jedp/STM32F030-breakout/README.md

# STM32F030 Breakout board

- 16MHz HSE
- 32k LSE
- USB C connector (power only - no USB on the F030)
- Both 3V3 and 3V3A
- 4-layer board

Dimensions: 1.3 x 2.55 in

PCB Image
