jedp/STM32F030-breakout/STM32F030-breakout.kicad_pcb

## KiCad design STM32F030-breakout.kicad_pcb (2024-01-16)

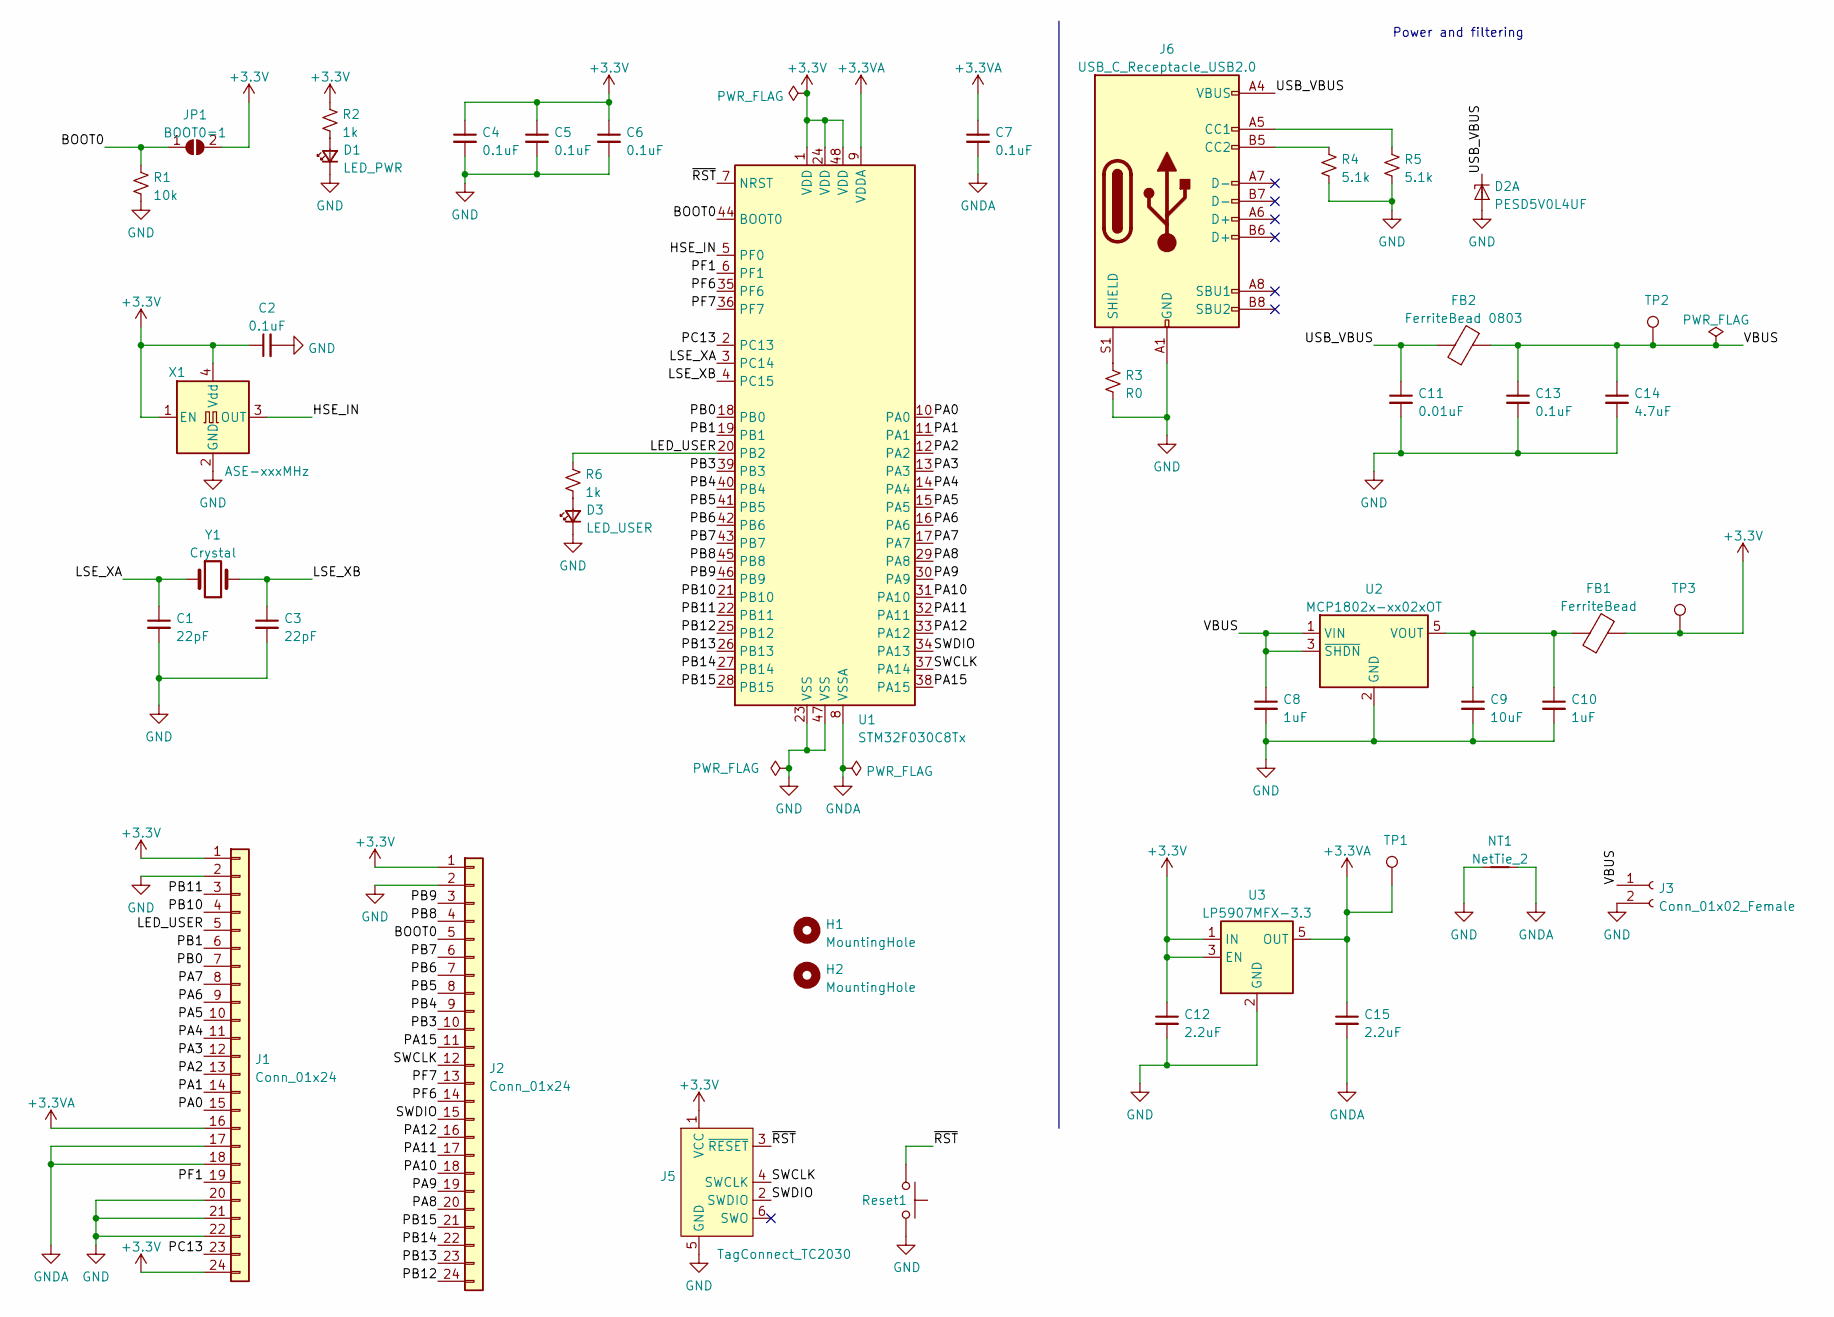
[picture p1: schematic STM32F030-breakout.kicad_sch, STM32F030]

Parts:
C1, C3: 22pF; C_0603_1608Metric
C2, C4, C5, C6, C7: 0.1uF; C_0603_1608Metric
C8, C10: 1uF; C_0603_1608Metric
C9: 10uF; C_0603_1608Metric
C11: 0.01uF; C_0603_1608Metric
C12, C15: 2.2uF; C_0603_1608Metric
C13: 0.1uF; C_0805_2012Metric
C14: 4.7uF; C_0805_2012Metric
D1: LED_PWR; LED_0603_1608Metric
D2: PESD5V0L4UF; SOT-886
D3: LED_USER; LED_0603_1608Metric
FB1: FerriteBead; L_0603_1608Metric
FB2: FerriteBead 0803; L_0805_2012Metric
H1, H2: MountingHole; MountingHole_2.2mm_M2
J1, J2: Conn_01x24; PinHeader_1x24_P2.54mm_Vertical
J3: Conn_01x02_Female; PinHeader_1x02_P2.54mm_Vertical
J5: TagConnect_TC2030; Tag-Connect_TC2030-IDC-FP_2x03_P1.27mm_Vertical
J6: USB_C_Receptacle_USB2.0; USB_C_Receptacle_GCT_USB4105-xx-A_16P_TopMnt_Horizontal
JP1: BOOT0=1; SolderJumper-2_P1.3mm_Open_TrianglePad1.0x1.5mm
NT1: NetTie_2; NetTie-2_SMD_Pad0.5mm
R1: 10k; R_0603_1608Metric
R2, R6: 1k; R_0603_1608Metric
R3: R0; R_0603_1608Metric
R4, R5: 5.1k; R_0603_1608Metric
Reset1: SW_Push; SW_SPST_B3U-1000P-B
TP1, TP2, TP3: TestPoint; TestPoint_Pad_D1.0mm
U1: STM32F030C8Tx; LQFP-48_7x7mm_P0.5mm
U2: MCP1802x-xx02xOT; SOT-23-5
U3: LP5907MFX-3.3; SOT-23-5
X1: ASE-xxxMHz; Oscillator_SMD_Abracon_ASE-4Pin_3.2x2.5mm
Y1: Crystal; Crystal_SMD_MicroCrystal_CC5V-T1A-2Pin_4.1x1.5mm

Connections:
+3.3V: C2.1, C4.1, C5.1, C6.1, C12.1, FB1.2, J1.1, J1.24, J2.1, J5.1 (VCC), JP1.2 (B), R2.1, TP3.1, U1.1 (VDD), U1.24 (VDD), U1.48 (VDD), U3.1 (IN), U3.3 (EN), X1.1 (EN), X1.4 (Vdd)
+3.3VA: C7.1, C15.1, J1.16, TP1.1, U1.9 (VDDA), U3.5 (OUT)
/BOOT0: J2.5, JP1.1 (A), R1.1, U1.44 (BOOT0)
/HSE_IN: U1.5 (PF0), X1.3 (OUT)
/LED_USER: J1.5, R6.1, U1.20 (PB2)
/LSE_XA: C1.1, U1.3 (PC14), Y1.1
/LSE_XB: C3.1, U1.4 (PC15), Y1.2
/PA0: J1.15, U1.10 (PA0)
/PA1: J1.14, U1.11 (PA1)
/PA2: J1.13, U1.12 (PA2)
/PA3: J1.12, U1.13 (PA3)
/PA4: J1.11, U1.14 (PA4)
/PA5: J1.10, U1.15 (PA5)
/PA6: J1.9, U1.16 (PA6)
/PA7: J1.8, U1.17 (PA7)
/PA8: J2.20, U1.29 (PA8)
/PA9: J2.19, U1.30 (PA9)
/PA10: J2.18, U1.31 (PA10)
/PA11: J2.17, U1.32 (PA11)
/PA12: J2.16, U1.33 (PA12)
/PA15: J2.11, U1.38 (PA15)
/PB0: J1.7, U1.18 (PB0)
/PB1: J1.6, U1.19 (PB1)
/PB3: J2.10, U1.39 (PB3)
/PB4: J2.9, U1.40 (PB4)
/PB5: J2.8, U1.41 (PB5)
/PB6: J2.7, U1.42 (PB6)
/PB7: J2.6, U1.43 (PB7)
/PB8: J2.4, U1.45 (PB8)
/PB9: J2.3, U1.46 (PB9)
/PB10: J1.4, U1.21 (PB10)
/PB11: J1.3, U1.22 (PB11)
/PB12: J2.24, U1.25 (PB12)
/PB13: J2.23, U1.26 (PB13)
/PB14: J2.22, U1.27 (PB14)
/PB15: J2.21, U1.28 (PB15)
/PC13: J1.23, U1.2 (PC13)
/PF1: J1.19, U1.6 (PF1)
/PF6: J2.14, U1.35 (PF6)
/PF7: J2.13, U1.36 (PF7)
/SWCLK: J2.12, J5.4 (SWCLK), U1.37 (PA14)
/SWDIO: J2.15, J5.2 (SWDIO), U1.34 (PA13)
/USB_VBUS: C11.1, D2.1 (K1), FB2.1, J6.A4 (VBUS), J6.A9 (VBUS), J6.B4 (VBUS), J6.B9 (VBUS)
/VBUS: C8.1, C13.1, C14.1, FB2.2, J3.1, TP2.1, U2.1 (VIN), U2.3 (~SHDN)
/~RST: J5.3 (~RESET), Reset1.1, U1.7 (NRST)
GND: C1.2, C2.2, C3.2, C4.2, C5.2, C6.2, C8.2, C9.2, C10.2, C11.2, C12.2, C13.2, C14.2, D1.1 (K), D2.2 (A), D2.5 (A), D3.1 (K), J1.2, J1.20, J1.21, J1.22, J2.2, J3.2, J5.5 (GND), J6.A1 (GND), J6.A12 (GND), J6.B1 (GND), J6.B12 (GND), NT1.1, R1.2, R3.2, R4.2, R5.2, Reset1.2, U1.23 (VSS), U1.47 (VSS), U2.2 (GND), U3.2 (GND), X1.2 (GND)
GNDA: C7.2, C15.2, J1.17, J1.18, NT1.2, U1.8 (VSSA)
unnamed: C9.1, C10.1, FB1.1, U2.5 (VOUT)
unnamed: D1.2 (A), R2.2
unnamed: D3.2 (A), R6.2
unnamed: J6.A5 (CC1), R5.1
unnamed: J6.B5 (CC2), R4.1
unnamed: J6.S1 (SHIELD), R3.1

Notes on the sheet:
Power and filtering

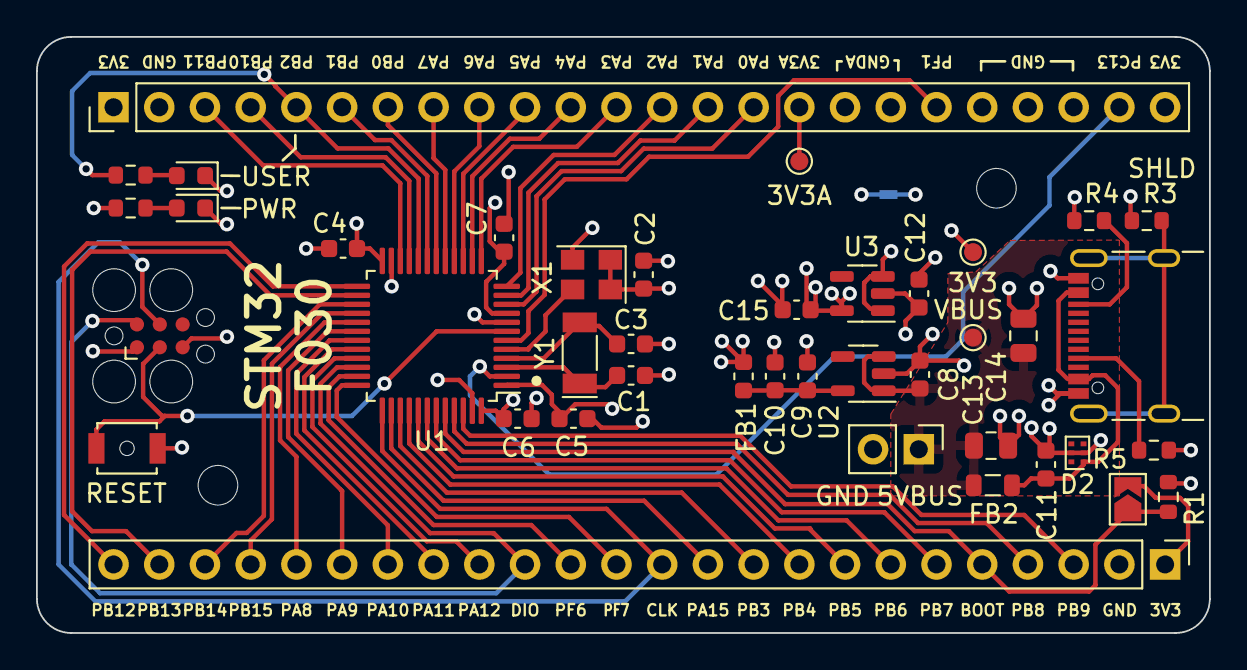
[picture p2: board STM32F030-breakout.kicad_pcb from above]

Board: 4 copper layers, 65.2 x 33.1 mm, 44 parts (1 on the bottom side), 53 nets.
