jedp/STM32F030-breakout/(commit log)

2023-12-27 STM32F030 breakout board
    [STM32F030-breakout.kicad_pcb, STM32F030-breakout.kicad_sch]
2024-01-04 Revision v1: 4-layer board; reset button
    [STM32F030-breakout.kicad_pcb, STM32F030-breakout.kicad_sch]
2024-01-14 Oof. SWDIO and SWCLK were on the wrong bank.
    I made the mistake of swapping out a different F030 symbol in Kicad. Turns out
    the A and B ports were swapped!
    [STM32F030-breakout.kicad_pcb, STM32F030-breakout.kicad_sch]
2024-01-16 Move oscillators closer
    [STM32F030-breakout.kicad_pcb]
